cdk1220/Wall-E/Motor_Lab_v8_image_black.png

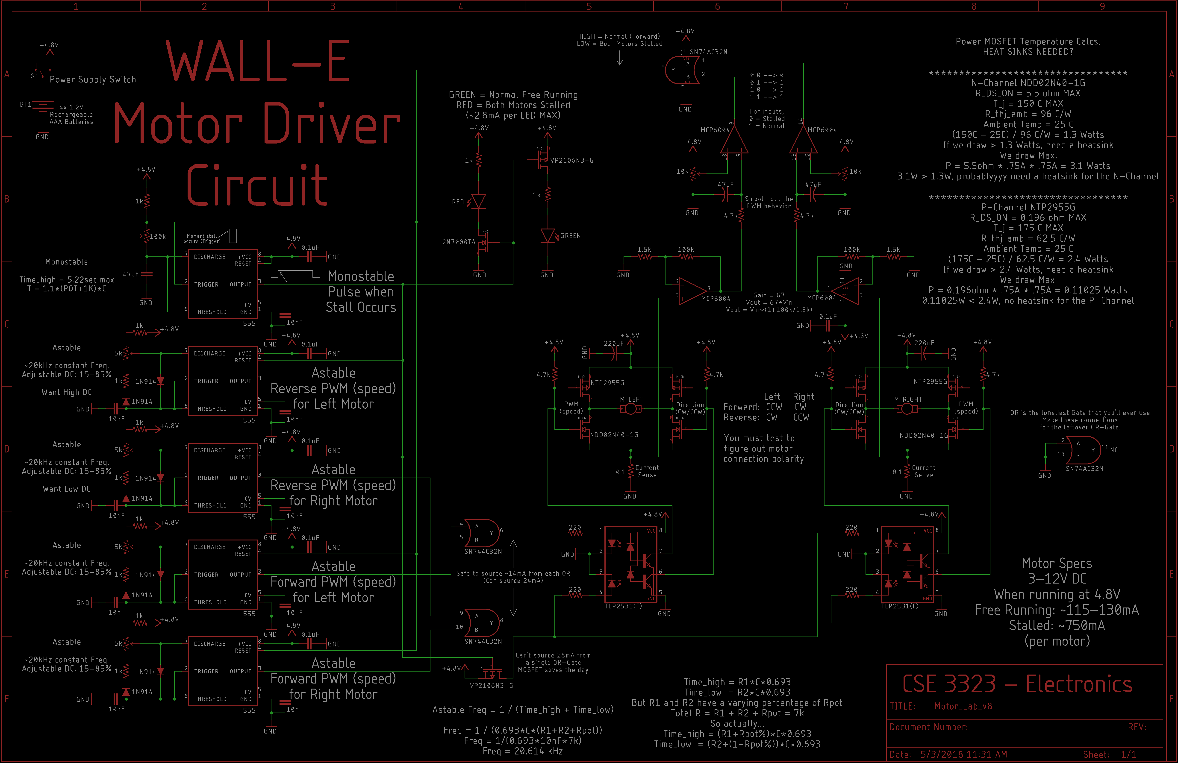
Motor_Lab_v8_image_black.png
