cdk1220/Wall-E/Motor_Lab_v8_image_white.png

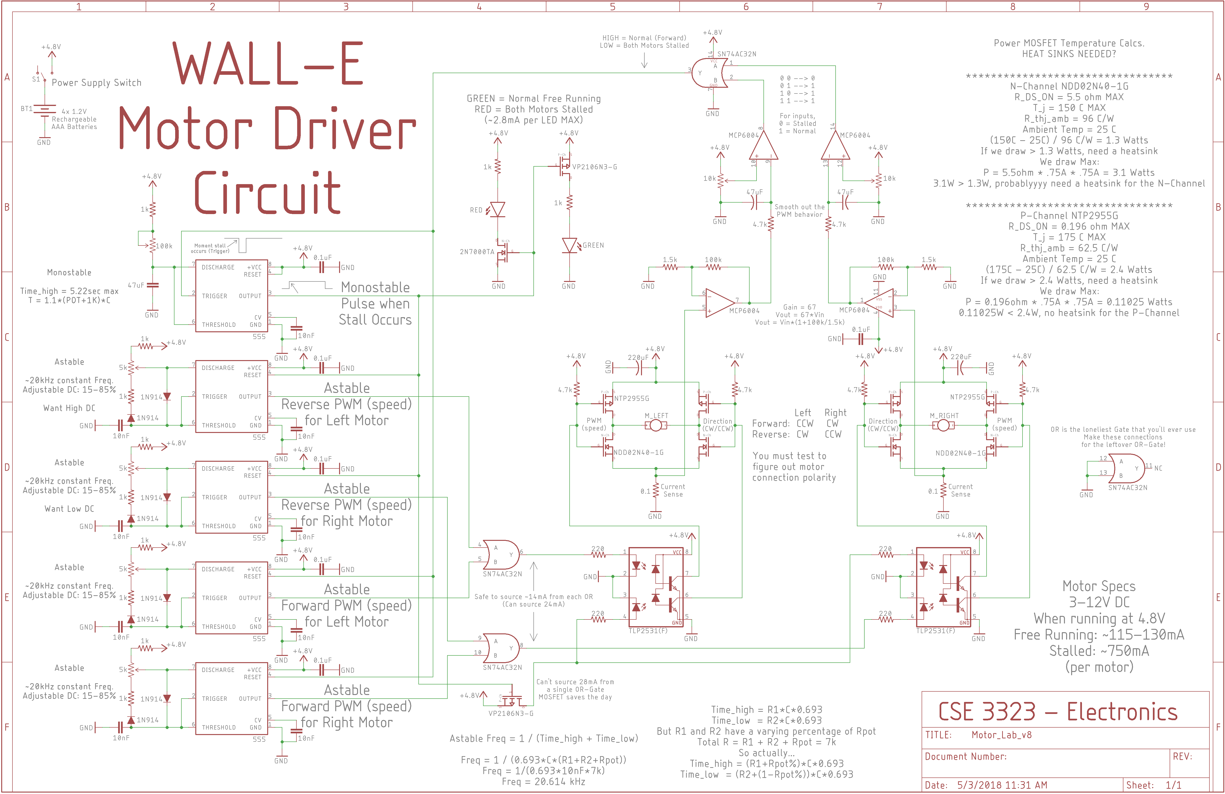
Motor_Lab_v8_image_white.png
