cdk1220/Wall-E/BOM_Motor_Driver_v8.pdf

Qty | Value | Part Description | Mouser Number | Qty | Value | Part Description | Mouser Number
2 | 0.1Ω | 2W Resistor (Current Sense) | 588-WLCR100FET (https://www.mouser.com/ProductDetail/588-WLCR100FET) | 5 | LMC555CN | 555 Timer IC (CMOS) | 926-LMC555CN/NOPB (https://www.mouser.com/ProductDetail/926-LMC555CN-NOPB)
4 | 220Ω | 1/4W Resistor | 660-CF1/4C361J (https://www.mouser.com/ProductDetail/660-CF1-4C361J) | 1 | MCP6002 | Dual Op-Amp IC | 579-MCP6002-I/P (https://www.mouser.com/ProductDetail/579-MCP6002-I-P)
11 | 1kΩ | 1/4W Resistor | 660-CF1/4C102J (https://www.mouser.com/ProductDetail/660-CF1-4C102J) | 1 | MCP6004 | Quad Op-Amp IC | 579-MCP6004-I/P (https://www.mouser.com/ProductDetail/Microchip-Technology/MCP6004-I-P?qs=sGAEpiMZZMvcAs5GUBtMdbwnPxN6uKeA)
2 | 1.5kΩ | 1/4W Resistor | 660-CF1/4C152J (https://www.mouser.com/ProductDetail/660-CF1-4C152J) | 2 | INA126PA | Instrumentation Amp. IC | 595-INA126PA (https://www.mouser.com/ProductDetail/595-INA126PA)
6 | 4.7kΩ | 1/4W Resistor | 660-CF1/4C473J (https://www.mouser.com/ProductDetail/660-CF1-4C473J) | 2 | TLP2531(F) | Dual Optocoupler IC | 757-TLP2531(F) (https://www.mouser.com/ProductDetail/Toshiba/TLP2531F)
1 | 10kΩ | 1/4W Resistor | 660-CF1/4C103J (https://www.mouser.com/ProductDetail/660-CF1-4C103J) | 1 | SN74AC32N | OR Logic Gate IC (2-input, 4-gate) | 595-SN74AC32N (https://www.mouser.com/ProductDetail/595-SN74AC32N)
2 | 15kΩ | 1/4W Resistor | 660-CF1/4C153J (https://www.mouser.com/ProductDetail/660-CF1-4C153J) | 1 | CD40107BE | NAND Logic Gate IC (2-input, 2-gate) | 595-CD40107BE (https://www.mouser.com/ProductDetail/595-CD40107BE)
2 | 100kΩ | 1/4W Resistor | 660-CF1/4C104J (https://www.mouser.com/ProductDetail/660-CF1-4C104J) | 4 | NDD02N40-1G | N-Ch. Power MOSFET 1.7A | 863-NDD02N40-1G (https://www.mouser.com/ProductDetail/ON-Semiconductor/NDD02N40-1G)
4 | 5kΩ | TRIMPOT | 652-3362H-1-502LF (https://www.mouser.com/ProductDetail/652-3362H-1-502LF) | 4 | NTP2955G | P-Ch. Power MOSFET 2.4A | 863-NTP2955G (https://www.mouser.com/ProductDetail/863-NTP2955G)
2 | 10kΩ | TRIMPOT | 652-3362P-1-103LF (https://www.mouser.com/ProductDetail/652-3362P-1-103LF) | 1 | 2N7000TA | N-Ch. Small Signal MOSFET 200mA | 512-2N7000TA (https://www.mouser.com/ProductDetail/ON-Semiconductor/2N7000TA)
1 | 100kΩ | TRIMPOT | 652-3362P-1-104LF (https://www.mouser.com/ProductDetail/652-3362P-1-104LF) | 2 | VP2106N3-G | P-Ch. Small Signal MOSFET 250mA | 689-VP2106N3-G (https://www.mouser.com/ProductDetail/Microchip-Technology/VP2106N3-G?qs=NZF3WWV0eEGNFUSyHi4JQQ%3D%3D)
9 | 10nF | Capacitor | 810-FA18X7R1H10300 (https://www.mouser.com/ProductDetail/810-FA18X7R1H10300) | 8 | 1N914 | Small Signal Diode | 512-1N914T50A (https://www.mouser.com/ProductDetail/512-1N914T50A)
6 | 0.1uF | Capacitor | 810-FA18X7R1H10400 (https://www.mouser.com/ProductDetail/810-FA18X7R1H10400) | 1 | SPDT | Slider Switch | 612-EG1218 (https://www.mouser.com/ProductDetail/612-EG1218)
1 | 47uF | Capacitor | 810-FG16X5R1E476MRT0 (https://www.mouser.com/ProductDetail/810-FG16X5R1E476MRT0) | 4 | AAA Battery | 1.2V AAA Battery | Amazon Link (https://www.amazon.com/dp/B00J18PFIO/?coliid=I20FTHFU0KCUJV&colid=MQE49648JA0H)
2 | 47uF | Electrolytic Cap. (Polarized) | 140-SEA470M1CSA0507 (https://www.mouser.com/ProductDetail/Lelon/SEA470M1CSA0507) | 2 | Motor | DC Motor | Amazon Link (https://www.amazon.com/YIKESHU-wheels-Chassis-Encoder-Arduino/dp/B073VHQT6P)
2 | 220uF | Electrolytic Cap. (Polarized) | 140-RGA221M1HBK1020G (https://www.mouser.com/ProductDetail/140-RGA221M1HBK1020G) | 1 | Robot Body | Robot Chassis Kit | Amazon Link (https://www.amazon.com/YIKESHU-wheels-Chassis-Encoder-Arduino/dp/B073VHQT6P)
1 | RED | LED 3mm | 604-WP710A10ID (https://www.mouser.com/ProductDetail/604-WP710A10ID) | 3 | Connectors | 2-Pole Screw Terminal Connectors | Amazon Link (https://www.amazon.com/Bestsupplier-100PCS-Pitch-Mount-Terminal/dp/B071DN7GQ5)
1 | GREEN | LED 3mm | 604-WP710A10GD (https://www.mouser.com/ProductDetail/604-WP710A10GD)

Bill of Materials for WALL-E Motor Driver Robot Circuit

CSE 3323 - Electronics

New additions in RED, Scrapped parts with Strikethrough
