cdk1220/Wall-E/Motor_Lab_v8.sch

## EAGLE design Motor_Lab_v8.sch (2018-05-14)

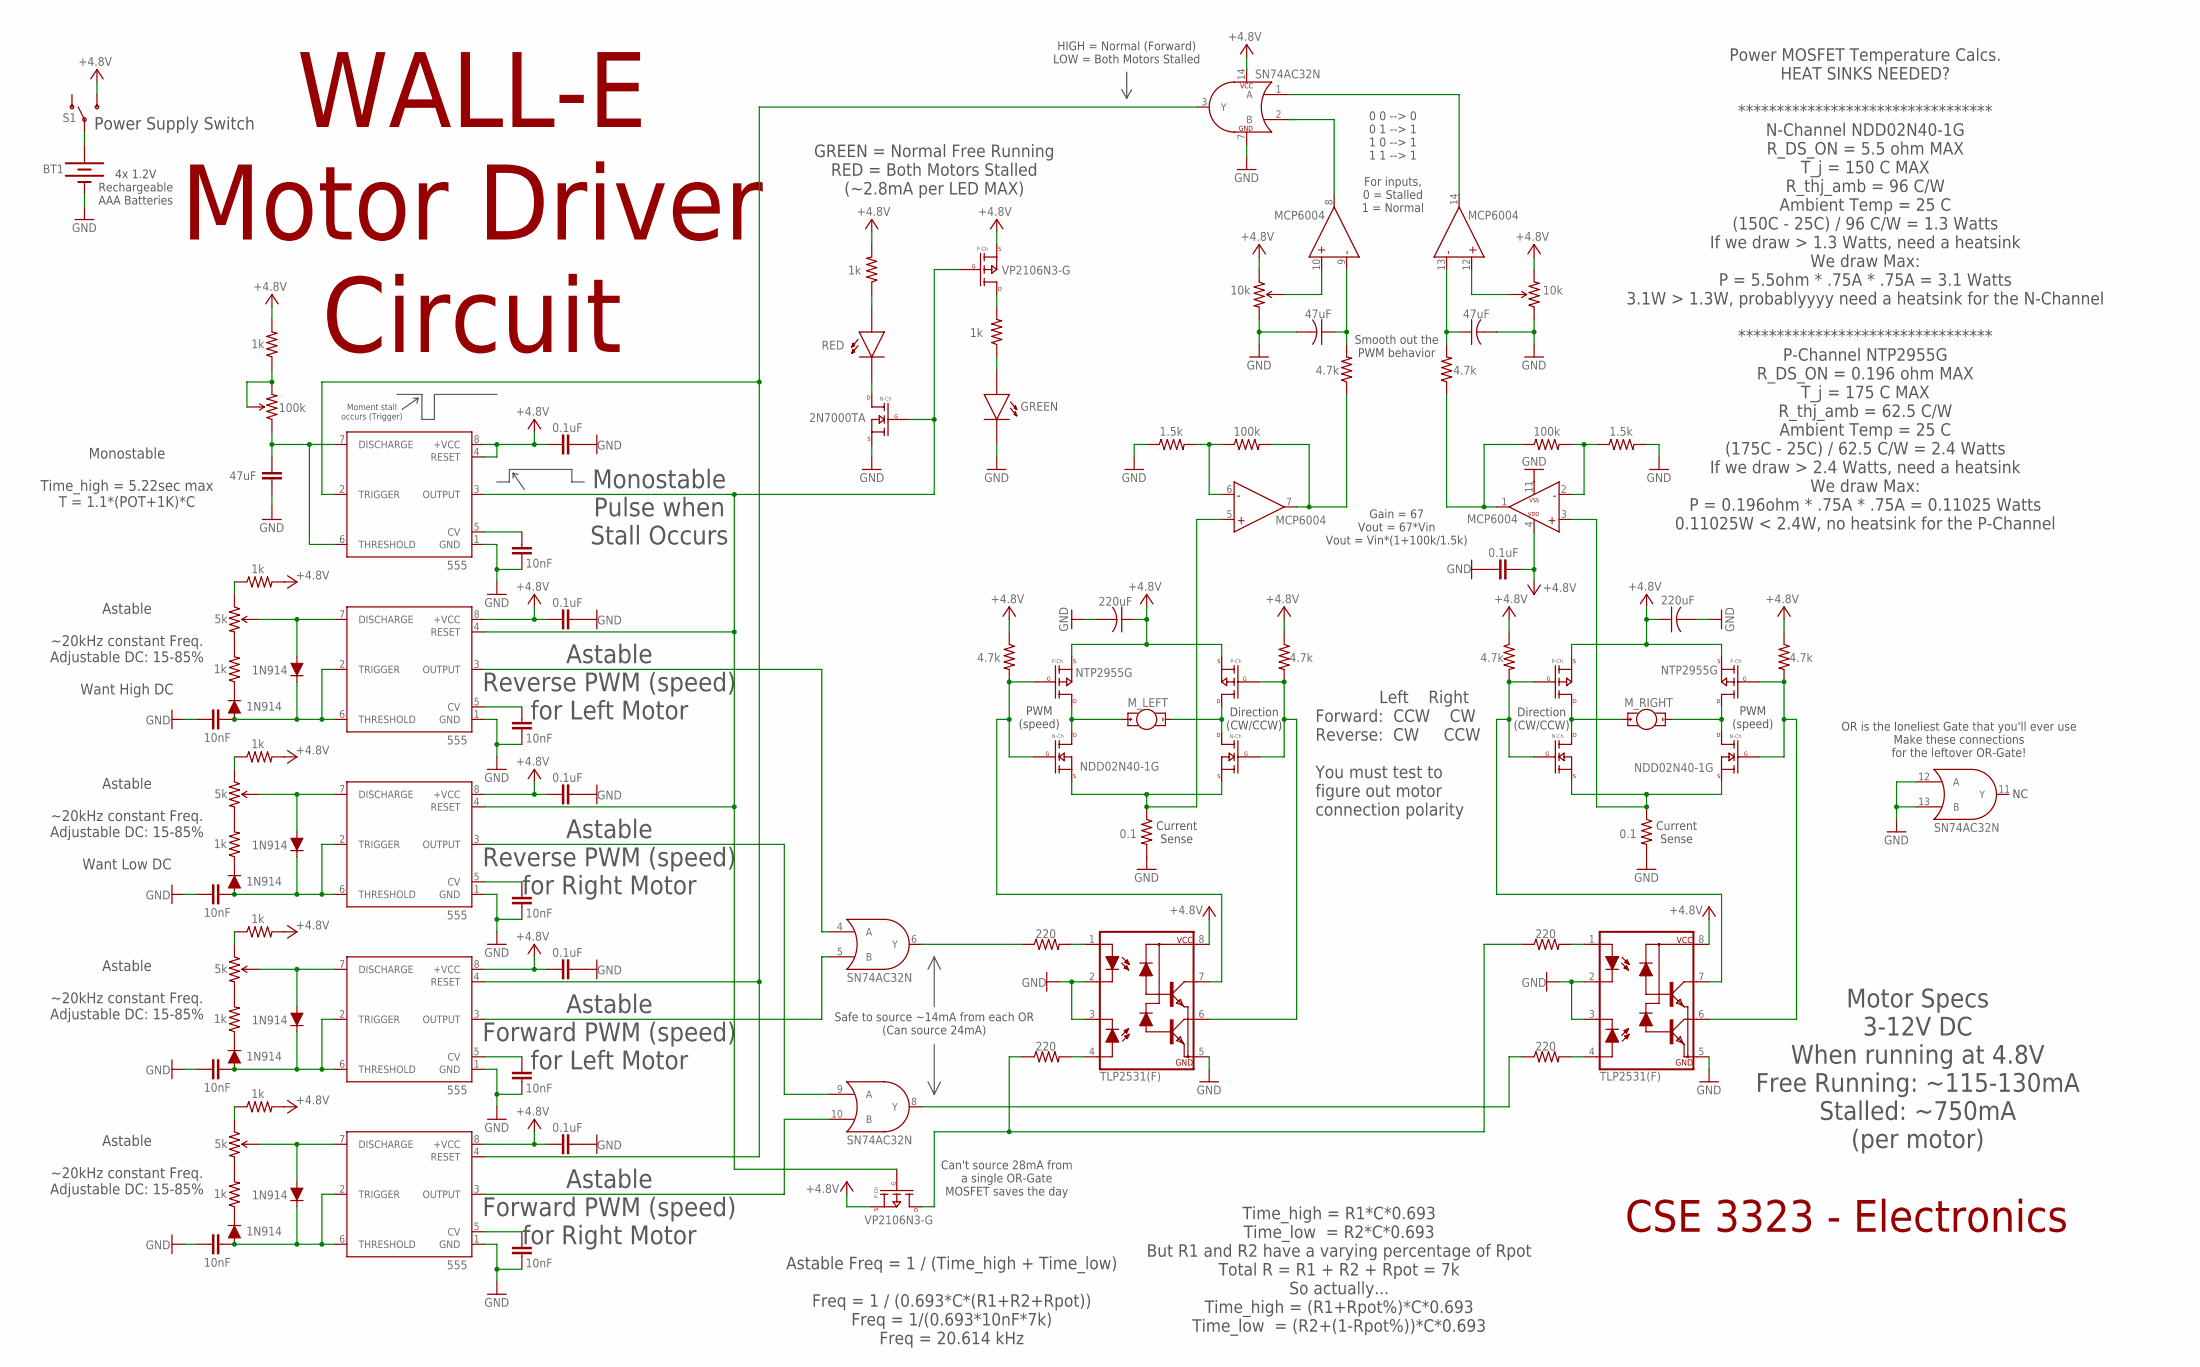
[picture p3: schematic Motor_Lab_v8.sch]

Parts:
BT1: BATTERY-AAA
C1, C2: 220uF; C025-024X044
C3, C5, C8, C10, C12, C14: 0.1uF; CAP-PTH-SMALL-KIT
C6, C7, C9, C11, C13, C15, C16, C17, C18: 10nF; CAP-PTH-SMALL-KIT
C19: 47uF; CAP-PTH-SMALL-KIT
C20, C22: 47uF; C025-024X044
D1: RED; LED5MM
D2: GREEN; LED5MM
D3, D4, D5, D6, D7, D8, D9, D10: 1N914; DIODE-1N4148
IC1, IC2, IC3, IC4, IC5: 555; DIP08
M_LEFT: MOTOR10MM; VIBE-MOTOR-10MM
M_RIGHT: MOTOR10MM; VIBE-MOTOR-10MM
POT1, POT4, POT5, POT6: 5k; TRIM_POT_PTH
POT7: 100k; TRIM_POT_PTH
POT8, POT9: 10k; TRIM_POT_PTH
R1, R2: 0.1; 0204V
R3, R4: 100k; 0204V
R5, R6: 1.5k; 0204V
R7, R8, R9, R10, R11, R12, R13, R14, R15, R16, R27: 1k; 0204V
R19, R21, R22, R23, R24, R25: 4.7k; 0204V
R20, R26, R28, R29: 220; 0204V
S1: SWITCH-SPDT-PTH-11.6X4.0MM; SWITCH_SPDT_PTH_11.6X4.0MM
U$1, U$4: STP3NK50Z; TO92-
U$2, U$3: NDD02N40-1G; TO92-
U$5, U$6, U$7, U$8: NTP2955G; TO92-
U$9: 2N7000TA; TO92-
U$10, U$12: VP2106N3-G; TO92-
U$11: SN74AC32N; DIP14
U$13, U$14: TLP2531(F); DIP08
U$15: MCP6004; DIP14

Connections:
GND: BT1.GND@1 (-), C1.2, C2.2, C3.1, C5.2, C6.1, C7.1, C8.2, C9.1, C10.2, C11.1, C12.2, C13.1, C14.2, C15.1, C16.1, C17.1, C18.1, C19.1, C20.2, C22.2, D2.K, IC1.1 (GND), IC2.1 (GND), IC3.1 (GND), IC4.1 (GND), IC5.1 (GND), POT8.3 (CW), POT9.1 (CCW), R1.2, R2.2, R5.1, R6.2, U$9.1 (SOURCE), U$11.7 (GND), U$11.12 (A), U$11.13 (B), U$13.2 (C1), U$13.3 (C2), U$13.5 (GND), U$14.2 (C1), U$14.3 (C2), U$14.5 (GND), U$15.11 (VSS)
unnamed: BT1.PWR@1 (+), S1.2
unnamed: M_LEFT.+, U$1.3 (DRAIN), U$5.1 (DRAIN)
unnamed: M_RIGHT.-, U$4.3 (DRAIN), U$8.1 (DRAIN)
unnamed: R29.1, U$11.8 (Y)
unnamed: IC1.3 (OUTPUT), U$11.10 (B)
unnamed: M_RIGHT.+, U$3.3 (DRAIN), U$7.1 (DRAIN)
unnamed: IC3.4 (RESET), IC4.4 (RESET), IC5.3 (OUTPUT), U$9.2 (GATE), U$10.2 (GATE), U$12.2 (GATE)
unnamed: R2.1, U$3.1 (SOURCE), U$4.1 (SOURCE), U$15.3 (IN+)
unnamed: R19.2, U$1.2 (GATE), U$5.2 (GATE), U$13.7 (VO1)
unnamed: D1.A, R7.1
unnamed: D1.K, U$9.3 (DRAIN)
unnamed: IC2.3 (OUTPUT), U$11.5 (B)
unnamed: R20.1, U$11.6 (Y)
unnamed: R3.2, R22.1, U$15.7 (OUT)
unnamed: R1.1, U$1.1 (SOURCE), U$2.1 (SOURCE), U$15.5 (IN+)
unnamed: R4.1, R24.1, U$15.1 (OUT)
unnamed: R3.1, R5.2, U$15.6 (IN-)
unnamed: POT8.2 (WIPER), U$15.10 (IN+)
unnamed: POT9.2 (WIPER), U$15.12 (IN+)
unnamed: M_LEFT.-, U$2.3 (DRAIN), U$6.1 (DRAIN)
unnamed: U$11.2 (B), U$15.8 (OUT)
unnamed: U$11.1 (A), U$15.14 (OUT)
unnamed: R8.2, U$10.1 (DRAIN)
unnamed: D2.A, R8.1
unnamed: IC3.3 (OUTPUT), U$11.9 (A)
unnamed: IC4.3 (OUTPUT), U$11.4 (A)
unnamed: C7.2, IC2.5 (CV)
unnamed: C9.2, IC3.5 (CV)
unnamed: C6.2, IC1.5 (CV)
unnamed: C11.2, IC4.5 (CV)
unnamed: C13.2, IC5.5 (CV)
unnamed: POT1.3 (CW), R10.2
unnamed: POT1.1 (CCW), R9.1
unnamed: D3.C, R10.1
unnamed: POT4.3 (CW), R12.2
unnamed: D4.A, IC1.7 (DISCHARGE), POT1.2 (WIPER)
unnamed: C15.2, D3.A, D4.C, IC1.2 (TRIGGER), IC1.6 (THRESHOLD)
unnamed: POT4.1 (CCW), R11.1
unnamed: D5.C, R12.1
unnamed: D6.A, IC2.7 (DISCHARGE), POT4.2 (WIPER)
unnamed: C16.2, D5.A, D6.C, IC2.2 (TRIGGER), IC2.6 (THRESHOLD)
unnamed: POT5.3 (CW), R14.2
unnamed: POT5.1 (CCW), R13.1
unnamed: D7.C, R14.1
unnamed: D8.A, IC3.7 (DISCHARGE), POT5.2 (WIPER)
unnamed: C17.2, D7.A, D8.C, IC3.2 (TRIGGER), IC3.6 (THRESHOLD)
unnamed: POT6.3 (CW), R16.2
unnamed: POT6.1 (CCW), R15.1
unnamed: D9.C, R16.1
unnamed: D10.A, IC4.7 (DISCHARGE), POT6.2 (WIPER)
unnamed: C18.2, D9.A, D10.C, IC4.2 (TRIGGER), IC4.6 (THRESHOLD)
unnamed: C19.2, IC5.6 (THRESHOLD), IC5.7 (DISCHARGE), POT7.1 (CCW)
unnamed: R4.2, R6.1, U$15.2 (IN-)
unnamed: IC1.4 (RESET), IC2.4 (RESET), IC5.2 (TRIGGER), U$11.3 (Y)
unnamed: R20.2, U$13.1 (A1)
unnamed: R28.2, U$13.4 (A2)
unnamed: C22.1, R22.2, U$15.9 (IN-)
unnamed: C20.1, R24.2, U$15.13 (IN-)
unnamed: R25.2, U$2.2 (GATE), U$6.2 (GATE), U$13.6 (VO2)
unnamed: R23.2, U$4.2 (GATE), U$8.2 (GATE), U$14.6 (VO2)
unnamed: R21.2, U$3.2 (GATE), U$7.2 (GATE), U$14.7 (VO1)
unnamed: POT7.2 (WIPER), POT7.3 (CW), R27.1
unnamed: R26.1, R28.1, U$12.1 (DRAIN)
unnamed: R26.2, U$14.1 (A1)
unnamed: R29.2, U$14.4 (A2)
VCC: C1.1, C2.1, C3.2, C5.1, C8.1, C10.1, C12.1, C14.1, IC1.8 (+VCC), IC2.8 (+VCC), IC3.8 (+VCC), IC4.8 (+VCC), IC5.4 (RESET), IC5.8 (+VCC), POT8.1 (CCW), POT9.3 (CW), R7.2, R9.2, R11.2, R13.2, R15.2, R19.1, R21.1, R23.1, R25.1, R27.2, S1.3 (S), U$5.3 (SOURCE), U$6.3 (SOURCE), U$7.3 (SOURCE), U$8.3 (SOURCE), U$10.3 (SOURCE), U$11.14 (VCC), U$12.3 (SOURCE), U$13.8 (VCC), U$14.8 (VCC), U$15.4 (VDD)

Notes on the sheet:
Gain = 67 Vout = 67*Vin Vout = Vin*(1+100k/1.5k)
GREEN = Normal Free Running RED = Both Motors Stalled (~2.8mA per LED MAX)
Astable Forward PWM (speed) for Right Motor
Astable Forward PWM (speed) for Left Motor
Astable Reverse PWM (speed) for Right Motor
Astable Reverse PWM (speed) for Left Motor
Monostable Pulse when Stall Occurs
PWM (speed)
Direction (CW/CCW)
4x 1.2V Rechargeable AAA Batteries
Astable ~20kHz constant Freq. Adjustable DC: 15-85%
Astable ~20kHz constant Freq. Adjustable DC: 15-85% Want Low DC
Astable ~20kHz constant Freq. Adjustable DC: 15-85% Want High DC
Monostable Time_high = 5.22sec max T = 1.1*(POT+1K)*C
Motor Specs 3-12V DC When running at 4.8V Free Running: ~115-130mA Stalled: ~750mA (per motor)
Time_high = R1*C*0.693 Time_low = R2*C*0.693 But R1 and R2 have a varying percentage of Rpot Total R = R1 + R2 + Rpot = 7k So actually... Time_high = (R1+Rpot%)*C*0.693 Time_low = (R2+(1-Rpot%))*C*0.693
Astable Freq = 1 / (Time_high + Time_low) Freq = 1 / (0.693*C*(R1+R2+Rpot)) Freq = 1/(0.693*10nF*7k) Freq = 20.614 kHz
WALL-E Motor Driver Circuit
Current Sense
Power Supply Switch
CSE 3323 - Electronics
HIGH = Normal (Forward) LOW = Both Motors Stalled
Moment stall occurs (Trigger)
Power MOSFET Temperature Calcs. HEAT SINKS NEEDED? ********************************* N-Channel NDD02N40-1G R_DS_ON = 5.5 ohm MAX T_j = 150 C MAX R_thj_amb = 96 C/W Ambient Temp = 25 C (150C - 25C) / 96 C/W = 1.3 Watts If we draw > 1.3 Watts, need a heatsink We draw Max: P = 5.5ohm * .75A * .75A = 3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
Safe to source ~14mA from each OR (Can source 24mA)
Left Right Forward: CCW CW Reverse: CW CCW You must test to figure out motor connection polarity
0 0 --> 0 0 1 --> 1 1 0 --> 1 1 1 --> 1 For inputs, 0 = Stalled 1 = Normal
Smooth out the PWM behavior
OR is the loneliest Gate that you'll ever use Make these connections for the leftover OR-Gate!
Can't source 28mA from a single OR-Gate MOSFET saves the day
